niw/mfk60/mfk60.kicad_pcb

## KiCad design mfk60.kicad_pcb (2024-01-25)

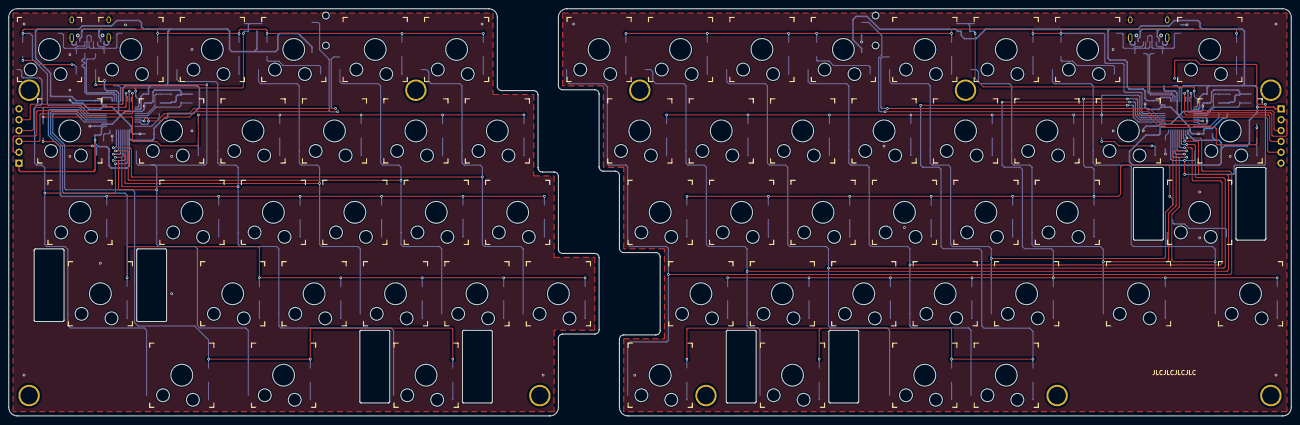
[picture p6: board mfk60.kicad_pcb from above]

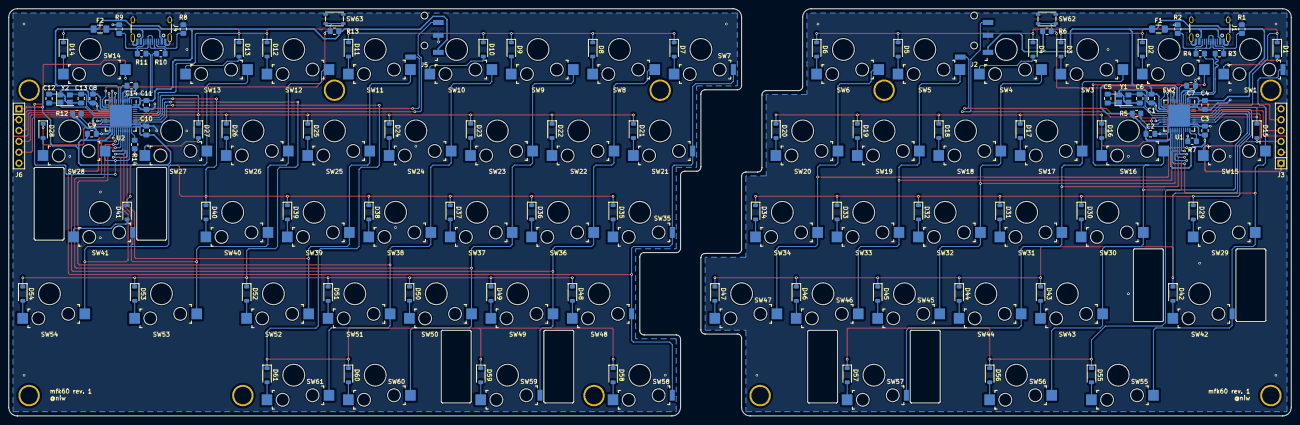
[picture p7: board mfk60.kicad_pcb from below]

Board: 2 copper layers, 300.0 x 95.2 mm, 181 parts (113 on the bottom side), 125 nets.

Parts:
C1, C2, C3, C8, C9, C10: 100n; C_0805_2012Metric_Pad1.18x1.45mm_HandSolder
C4, C11: 10u; C_0805_2012Metric_Pad1.18x1.45mm_HandSolder
C5, C6, C12, C13: 22p; C_0805_2012Metric_Pad1.18x1.45mm_HandSolder
C7, C14: 1u; C_0805_2012Metric_Pad1.18x1.45mm_HandSolder
D1, D2, D3, D4, D5, D6, D7, D8, D9, D10, D11, D12, D13, D14, D15, D16, D17, D18, D19, D20, D21, D22, D23, D24, D25, D26, D27, D28, D29, D30, D31, D32, D33, D34, D35, D36, D37, D38, D39, D40, D41, D42, D43, D44, D45, D46, D47, D48, D49, D50, D51, D52, D53, D54, D55, D56, D57, D58, D59, D60, D61: D; D_SOD-123
F1, F2: 500m; Fuse_1206_3216Metric_Pad1.42x1.75mm_HandSolder
H1, H2, H3, H4, H5, H6, H7, H8, H9, H10: MountingHole; MountingHole_4mm_Spacer
J1, J4: USB_C_Receptacle_USB2.0; USB_C_Receptacle_HRO_TYPE-C-31-M-12
J2, J5: TRRS Jack; TRRS_Jack_3.5mm_PJ320D
J3, J6: ISP; Debug_Pin_1x6_P2.54mm
R1, R2, R8, R9: 5.1k; R_0805_2012Metric_Pad1.20x1.40mm_HandSolder
R3, R4, R10, R11: 22; R_0805_2012Metric_Pad1.20x1.40mm_HandSolder
R5, R6, R7, R12, R13, R14: 10k; R_0805_2012Metric_Pad1.20x1.40mm_HandSolder
SW1, SW7, SW21, SW35, SW48, SW58: KS-33; Gateron_Low_Profile_Socket_Edge
SW2, SW3, SW4, SW5, SW6, SW8, SW9, SW10, SW11, SW12, SW13, SW14, SW15, SW16, SW17, SW18, SW19, SW20, SW22, SW23, SW24, SW25, SW26, SW27, SW28, SW29, SW30, SW31, SW32, SW33, SW34, SW36, SW37, SW38, SW39, SW40, SW43, SW44, SW45, SW46, SW47, SW49, SW50, SW51, SW52, SW53, SW54, SW55, SW56, SW60, SW61: KS-33; Gateron_Low_Profile_Socket
SW41, SW42, SW57, SW59: KS-33; Gateron_Low_Profile_Socket_Stabilizer_2U
SW62, SW63: RST; SW_Push_Alps_Alpine_SKRPACE010
T1, T2, T3, T4, T5, T6, T7: Tab
U1, U2: ATmega32U4-M; QFN-44-1EP_7x7mm_P0.5mm_EP5.2x5.2mm
Y1, Y2: 16M; Crystal_SMD_3225-4Pin_3.2x2.5mm

Connections:
+5V: C1.2, C2.2, C3.2, C4.2, F1.2, J2.4 (Tip), J3.1, R5.2, R6.2, U1.2 (UVCC), U1.7 (VBUS), U1.14 (VCC), U1.24 (AVCC), U1.34 (VCC), U1.44 (AVCC)
/Left/USB_CC1: J1.A5 (CC1), R1.1
/Left/USB_CC2: J1.B5 (CC2), R2.1
/Left/USB_VBUS: F1.1, J1.A4 (VBUS), J1.A9 (VBUS), J1.B4 (VBUS), J1.B9 (VBUS)
/Righ/R_USB_CC1: J4.A5 (CC1), R8.1
/Righ/R_USB_CC2: J4.B5 (CC2), R9.1
/Righ/R_USB_VBUS: F2.1, J4.A4 (VBUS), J4.A9 (VBUS), J4.B4 (VBUS), J4.B9 (VBUS)
COL1: SW1.1, SW15.1, SW29.1, SW42.1, SW55.1, U1.25 (PD4)
COL2: SW2.1, SW16.1, SW30.1, SW43.1, SW56.1, U1.26 (PD6)
COL3: SW3.1, SW17.1, SW31.1, SW44.1, SW57.1, U1.27 (PD7)
COL4: SW4.1, SW18.1, SW32.1, SW45.1, U1.28 (PB4)
COL5: SW5.1, SW19.1, SW33.1, SW46.1, U1.29 (PB5)
COL6: SW6.1, SW20.1, SW34.1, SW47.1, U1.30 (PB6)
COL7: SW7.1, SW21.1, SW35.1, SW48.1, SW58.1, U2.25 (PD4)
COL8: SW8.1, SW22.1, SW36.1, SW49.1, SW59.1, U2.26 (PD6)
COL9: SW9.1, SW23.1, SW37.1, SW50.1, SW60.1, U2.27 (PD7)
COL10: SW10.1, SW24.1, SW38.1, SW51.1, SW61.1, U2.28 (PB4)
COL11: SW11.1, SW25.1, SW39.1, SW52.1, U2.29 (PB5)
COL12: SW12.1, SW26.1, SW40.1, SW53.1, U2.30 (PB6)
COL13: SW13.1, SW27.1, SW41.1, SW54.1, U2.31 (PC6)
COL14: SW14.1, SW28.1, U2.32 (PC7)
GND: C1.1, C2.1, C3.1, C4.1, C5.2, C6.2, C7.1, J1.A1 (GND), J1.A12 (GND), J1.B1 (GND), J1.B12 (GND), J1.S1 (SHIELD), J2.3 (Ring_1), J3.6, R1.2, R2.2, R7.1, SW62.2, U1.5 (UGND), U1.15 (GND), U1.23 (GND), U1.35 (GND), U1.43 (GND), U1.45 (GND), Y1.2, Y1.4
MISO: J3.3, U1.11 (PB3)
MOSI: J3.2, U1.10 (PB2)
unnamed: D1.2 (A), SW1.2
unnamed: D2.2 (A), SW2.2
unnamed: D3.2 (A), SW3.2
unnamed: D4.2 (A), SW4.2
unnamed: D5.2 (A), SW5.2
unnamed: D6.2 (A), SW6.2
unnamed: D7.2 (A), SW7.2
unnamed: D8.2 (A), SW8.2
unnamed: D9.2 (A), SW9.2
unnamed: D10.2 (A), SW10.2
unnamed: D11.2 (A), SW11.2
unnamed: D12.2 (A), SW12.2
unnamed: D13.2 (A), SW13.2
unnamed: D14.2 (A), SW14.2
unnamed: D15.2 (A), SW15.2
unnamed: D16.2 (A), SW16.2
unnamed: D17.2 (A), SW17.2
unnamed: D18.2 (A), SW18.2
unnamed: D19.2 (A), SW19.2
unnamed: D20.2 (A), SW20.2
unnamed: D21.2 (A), SW21.2
unnamed: D22.2 (A), SW22.2
unnamed: D23.2 (A), SW23.2
unnamed: D24.2 (A), SW24.2
unnamed: D25.2 (A), SW25.2
unnamed: D26.2 (A), SW26.2
unnamed: D27.2 (A), SW27.2
unnamed: D28.2 (A), SW28.2
unnamed: D29.2 (A), SW29.2
unnamed: D30.2 (A), SW30.2
unnamed: D31.2 (A), SW31.2
unnamed: D32.2 (A), SW32.2
unnamed: D33.2 (A), SW33.2
unnamed: D34.2 (A), SW34.2
unnamed: D35.2 (A), SW35.2
unnamed: D36.2 (A), SW36.2
unnamed: D37.2 (A), SW37.2
unnamed: D38.2 (A), SW38.2
unnamed: D39.2 (A), SW39.2
unnamed: D40.2 (A), SW40.2
unnamed: D41.2 (A), SW41.2
unnamed: D42.2 (A), SW42.2
unnamed: D43.2 (A), SW43.2
unnamed: D44.2 (A), SW44.2
unnamed: D45.2 (A), SW45.2
unnamed: D46.2 (A), SW46.2
unnamed: D47.2 (A), SW47.2
unnamed: D48.2 (A), SW48.2
unnamed: D49.2 (A), SW49.2
unnamed: D50.2 (A), SW50.2
unnamed: D51.2 (A), SW51.2
unnamed: D52.2 (A), SW52.2
unnamed: D53.2 (A), SW53.2
unnamed: D54.2 (A), SW54.2
unnamed: D55.2 (A), SW55.2
unnamed: D56.2 (A), SW56.2
unnamed: D57.2 (A), SW57.2
unnamed: D58.2 (A), SW58.2
unnamed: D59.2 (A), SW59.2
unnamed: D60.2 (A), SW60.2
unnamed: D61.2 (A), SW61.2
unnamed: J1.A6 (D+), J1.B6 (D+), R4.1
unnamed: J1.A7 (D-), J1.B7 (D-), R3.1
unnamed: J4.A6 (D+), J4.B6 (D+), R11.1
unnamed: J4.A7 (D-), J4.B7 (D-), R10.1
unnamed: C7.2, U1.6 (UCAP)
unnamed: R7.2, U1.33 (~HWB/PE2)
unnamed: C14.2, U2.6 (UCAP)
unnamed: R14.2, U2.33 (~HWB/PE2)
RESET: J3.5, R6.1, SW62.1, U1.13 (~RESET)
ROW1: D1.1 (K), D2.1 (K), D3.1 (K), D4.1 (K), D5.1 (K), D6.1 (K), U1.40 (PF1)
ROW2: D15.1 (K), D16.1 (K), D17.1 (K), D18.1 (K), D19.1 (K), D20.1 (K), U1.39 (PF4)
ROW3: D29.1 (K), D30.1 (K), D31.1 (K), D32.1 (K), D33.1 (K), D34.1 (K), U1.38 (PF5)
ROW4: D42.1 (K), D43.1 (K), D44.1 (K), D45.1 (K), D46.1 (K), D47.1 (K), U1.37 (PF6)
ROW5: D55.1 (K), D56.1 (K), D57.1 (K), U1.36 (PF7)
R_+5V: C8.2, C9.2, C10.2, C11.2, F2.2, J5.4 (Tip), J6.1, R13.2, U2.2 (UVCC), U2.7 (VBUS), U2.14 (VCC), U2.24 (AVCC), U2.34 (VCC), U2.44 (AVCC)
R_GND: C8.1, C9.1, C10.1, C11.1, C12.2, C13.2, C14.1, J4.A1 (GND), J4.A12 (GND), J4.B1 (GND), J4.B12 (GND), J4.S1 (SHIELD), J5.3 (Ring_1), J6.6, R8.2, R9.2, R12.1, R14.1, SW63.2, U2.5 (UGND), U2.15 (GND), U2.23 (GND), U2.35 (GND), U2.43 (GND), U2.45 (GND), Y2.2, Y2.4
R_MISO: J6.3, U2.11 (PB3)
R_MOSI: J6.2, U2.10 (PB2)
R_RESET: J6.5, R13.1, SW63.1, U2.13 (~RESET)
R_ROW1: D7.1 (K), D8.1 (K), D9.1 (K), D10.1 (K), D11.1 (K), D12.1 (K), D13.1 (K), D14.1 (K), U2.40 (PF1)
R_ROW2: D21.1 (K), D22.1 (K), D23.1 (K), D24.1 (K), D25.1 (K), D26.1 (K), D27.1 (K), D28.1 (K), U2.39 (PF4)
R_ROW3: D35.1 (K), D36.1 (K), D37.1 (K), D38.1 (K), D39.1 (K), D40.1 (K), D41.1 (K), U2.38 (PF5)
R_ROW4: D48.1 (K), D49.1 (K), D50.1 (K), D51.1 (K), D52.1 (K), D53.1 (K), D54.1 (K), U2.37 (PF6)
R_ROW5: D58.1 (K), D59.1 (K), D60.1 (K), D61.1 (K), U2.36 (PF7)
R_SCLK: J6.4, U2.9 (PB1)
R_SCL_SERIAL: J5.2 (Ring_2), U2.18 (PD0), U2.20 (PD2)
R_SDA: J5.5 (Sleeve), U2.19 (PD1)
R_SPLIT_HAND: R12.2, U2.22 (PD5)
R_USB_D+: R11.2, U2.4 (D+)
R_USB_D-: R10.2, U2.3 (D-)
R_XTAL1: C12.1, U2.17 (XTAL1), Y2.1
R_XTAL2: C13.1, U2.16 (XTAL2), Y2.3
SCLK: J3.4, U1.9 (PB1)
SCL_SERIAL: J2.2 (Ring_2), U1.18 (PD0), U1.20 (PD2)
SDA: J2.5 (Sleeve), U1.19 (PD1)
SPLIT_HAND: R5.1, U1.22 (PD5)
USB_D+: R4.2, U1.4 (D+)
USB_D-: R3.2, U1.3 (D-)
XTAL1: C5.1, U1.17 (XTAL1), Y1.1
XTAL2: C6.1, U1.16 (XTAL2), Y1.3
