niw/mfk60/(commit log)

2024-01-12 Add a script to create plate boards.
2024-01-12 Initial complete work of mfk60.
    [mfk60.kicad_pcb, mfk60.kicad_sch, mfk60_bottom_plate.kicad_pcb, mfk60_left.kicad_sch, mfk60_matrix.kicad_sch, mfk60_middle_plate.kicad_pcb, mfk60_right.kicad_sch, mfk60_top_plate.kicad_pcb]
2024-01-12 Adjust JLC text position and add it to script.
    [mfk60.kicad_pcb, mfk60_bottom_plate.kicad_pcb, mfk60_middle_plate.kicad_pcb, mfk60_top_plate.kicad_pcb]
2024-01-13 Add pull-up resistor on left side.
    [mfk60.kicad_pcb, mfk60_left.kicad_sch, mfk60_right.kicad_sch]
2024-01-13 FIX: key and diode value
    [mfk60.kicad_pcb, mfk60_left.kicad_sch, mfk60_matrix.kicad_sch, mfk60_right.kicad_sch]
2024-01-13 Adjust differential pairs
    [mfk60.kicad_pcb]
2024-01-13 Minor alignment fix.
    [mfk60.kicad_pcb]
2024-01-13 Update comments.
    [mfk60_bottom_plate.kicad_pcb, mfk60_left.kicad_sch, mfk60_matrix.kicad_sch, mfk60_middle_plate.kicad_pcb, mfk60_right.kicad_sch, mfk60_top_plate.kicad_pcb]
2024-01-13 Add missing npth for USB-C socket.
    [mfk60_middle_plate.kicad_pcb]
2024-01-13 Add missing cut for USB-C socket.
    [mfk60_bottom_plate.kicad_pcb]
2024-01-25 Multiple changes to produce production file
    - Set missing board only flag.
    - Set exclude from position files flags as well.
    - Update JCL text position for plates.
    - Fix origin.
    - Minor updates.
    [mfk60.kicad_pcb, mfk60_left.kicad_sch, mfk60_middle_plate.kicad_pcb, mfk60_right.kicad_sch]
2024-01-25 Update Bash scripts.
    - `KICAD_PYTHON_PATH` to change KiCad `python` path.
    - Set protective Bash options.
    - Use `readonly`.
